Michel-0/Nixie/NTC/CAD/GPS.FCStd

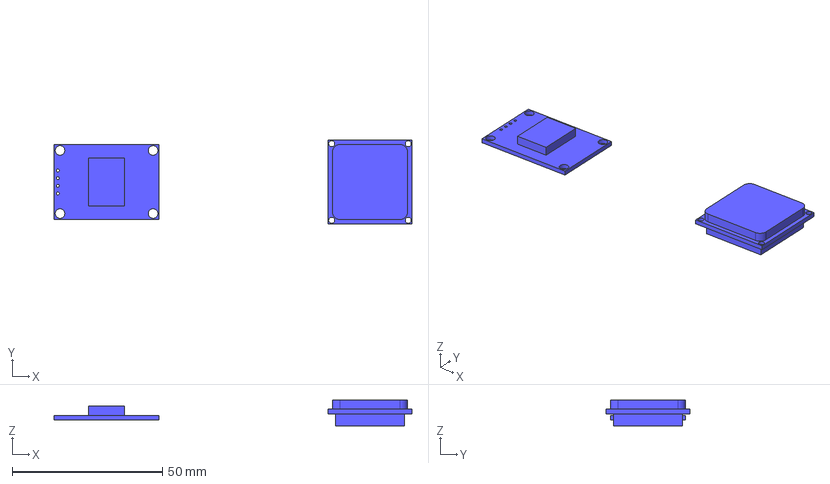
[picture p1: CAD file, 2025-02-01]
NTC/CAD/GPS.FCStd
119.3 x 28.0 x 8.50 mm
