Michel-0/Nixie/NTC/CAD/RTC.FCStd

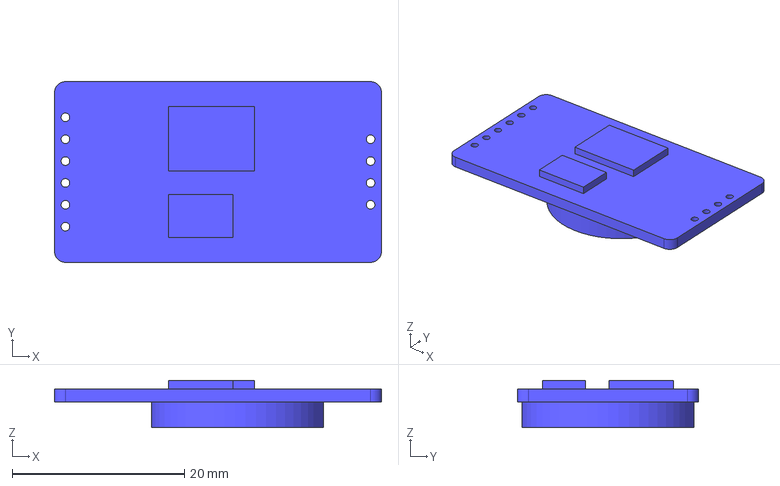
[picture p2: CAD file, 2025-01-15]
NTC/CAD/RTC.FCStd
38.0 x 21.0 x 5.50 mm
