Michel-0/Nixie/NTC/CAD/IN-3.FCStd

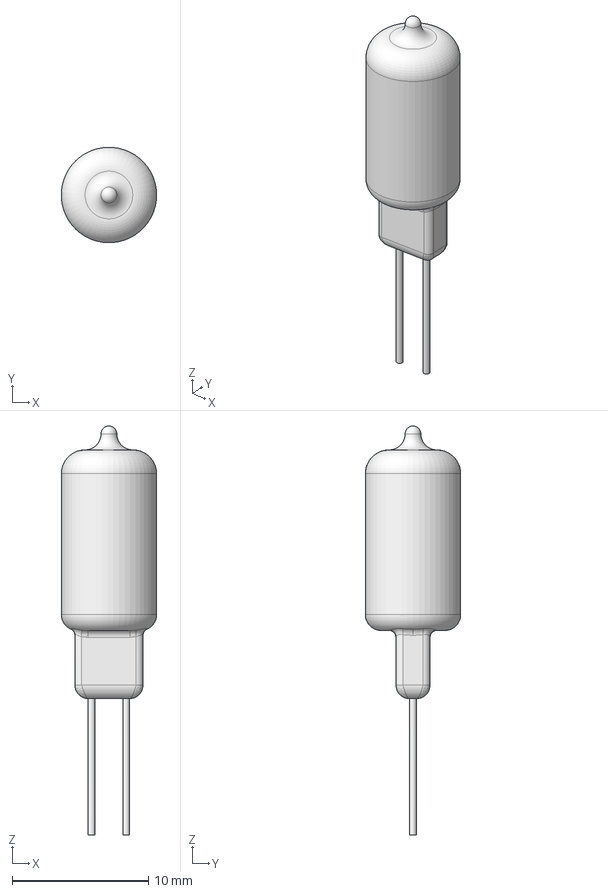
[picture p3: CAD file, 2025-01-02]
NTC/CAD/IN-3.FCStd
6.99 x 7.00 x 30.0 mm
