Michel-0/Nixie/NTC/CAD/PCB_5x6.FCStd

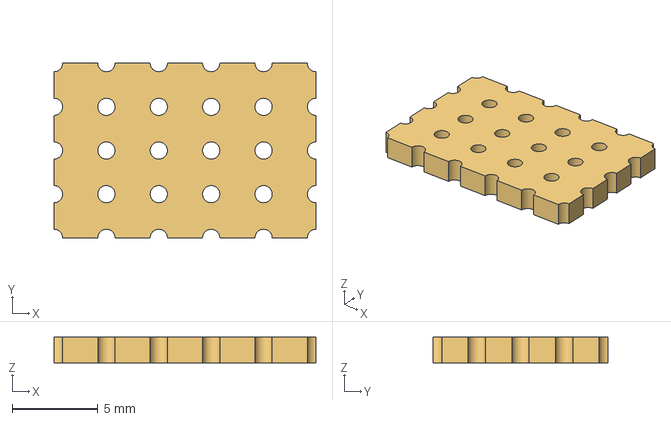
[picture p4: CAD file, 2025-01-02]
NTC/CAD/PCB_5x6.FCStd
15.2 x 10.2 x 1.50 mm
