Michel-0/Nixie/NTC/CAD/DCDC.FCStd

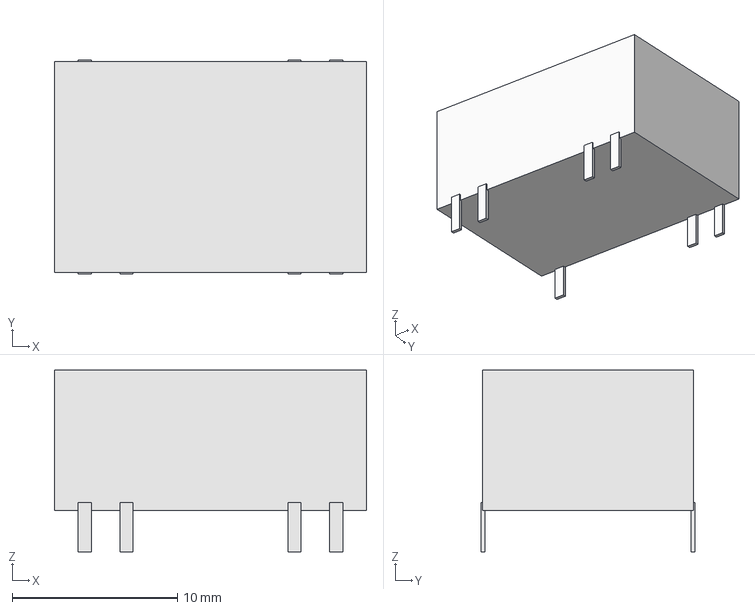
[picture p5: CAD file, 2025-01-01]
NTC/CAD/DCDC.FCStd
18.9 x 12.9 x 11.0 mm
