Michel-0/Nixie/NTC/CAD/IN-14.FCStd

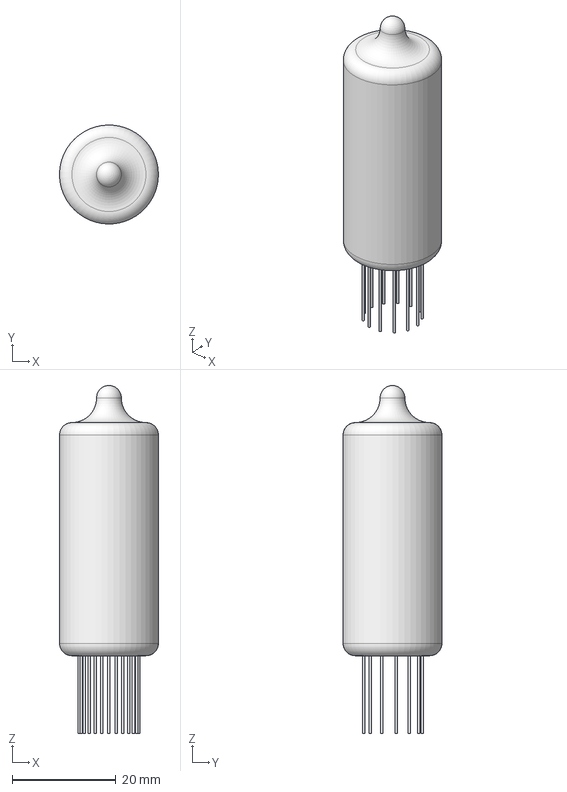
[picture p7: CAD file, 2025-01-01]
NTC/CAD/IN-14.FCStd
19.1 x 19.1 x 67.2 mm
