Michel-0/Nixie/NTC/CAD/DCF77.FCStd

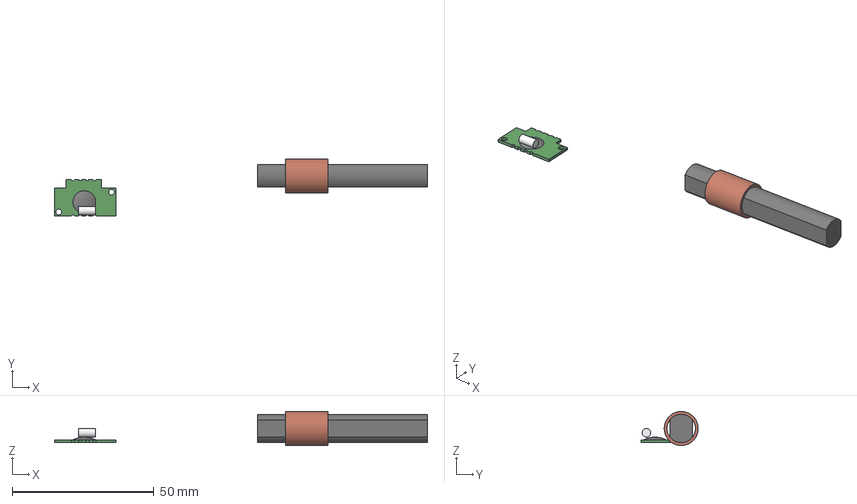
[picture p8: CAD file, 2025-01-01]
NTC/CAD/DCF77.FCStd
131.5 x 20.3 x 12.0 mm
Zylinder
