Michel-0/Nixie/NTC/Main.kicad_pcb

## KiCad design NTC/Main.kicad_pcb (2025-02-01)

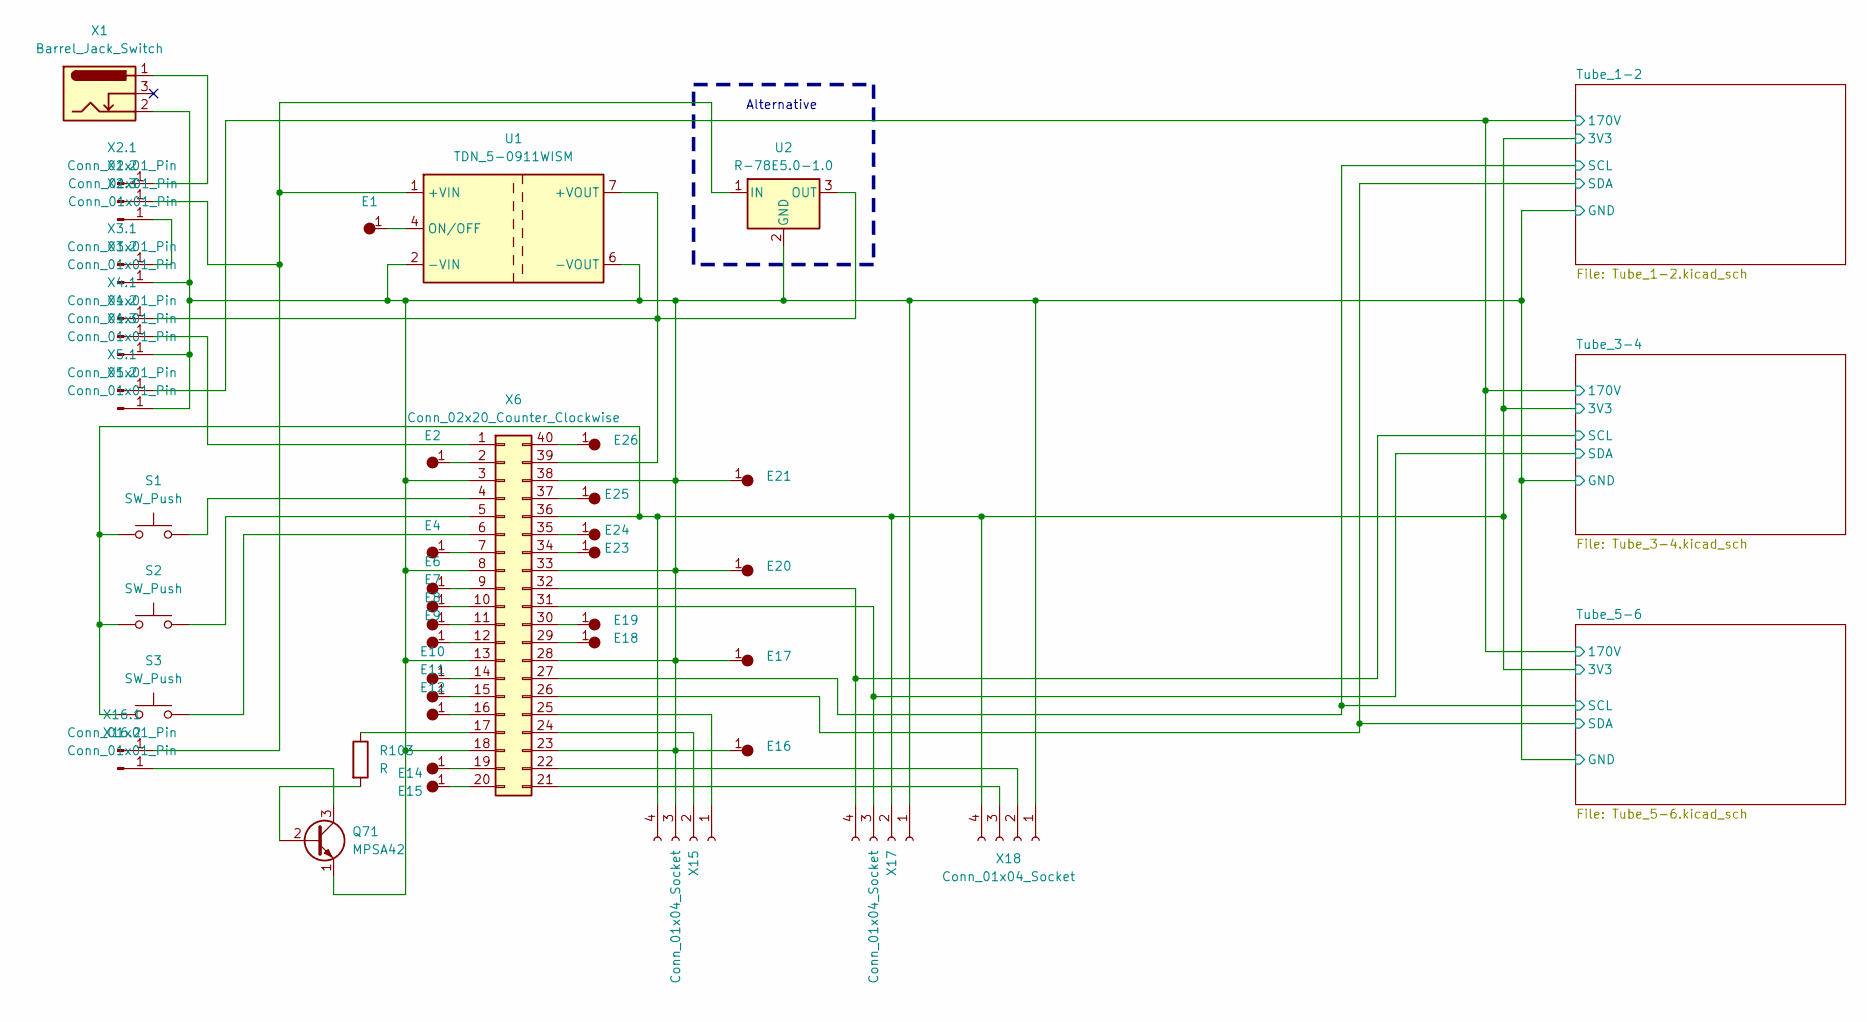
[picture p9: schematic Main.kicad_sch]

Parts:
E1, E2, E4, E6, E7, E8, E9, E10, E11, E12, E14, E15, E16, E17, E18, E19, E20, E21, E23, E24, E25, E26: SingleHole
Q71: MPSA42; MPSA-42
R103: R; Resistor-a
S1, S2, S3: SW_Push; Button
U1: TDN_5-0911WISM; DCDC_12V-5V-3W
U2: R-78E5.0-1.0; DCDC_12V-5V-5W
X1: Barrel_Jack_Switch; Socket_5-5
X2.1, X2.2, X2.3, X3.1, X3.2, X4.1, X4.2, X4.3, X5.1, X5.2, X16.1, X16.2: Conn_01x01_Pin; Pin_D1.0mm_L10.0mm
X6: Conn_02x20_Counter_Clockwise; Pinbar_1-20-f
X15: Conn_01x04_Socket; Pinbar_1-4-f-b
X17: Conn_01x04_Socket; Pinbar_1-4-f-c
X18: Conn_01x04_Socket; Pinbar_1-4-f-d

Connections:
/Tube_1-2/3V3: S1.1, S2.1, S3.1, X6.36, X15.4, X17.2, X18.4; also elsewhere on the board
/Tube_1-2/170V: X5.1.1; also elsewhere on the board
/Tube_1-2/GND: E16.1, E17.1, E20.1, E21.1, Q71.1 (E), U1.2 (-VIN), U1.6 (-VOUT), U2.2 (GND), X1.2, X3.2.1, X4.3.1, X5.2.1, X6.3, X6.8, X6.13, X6.18, X6.23, X6.28, X6.33, X6.38, X15.3, X17.1, X18.1; also elsewhere on the board
/Tube_1-2/SCL: X6.27; also elsewhere on the board
/Tube_1-2/SDA: X6.26; also elsewhere on the board
/Tube_3-4/SCL: X6.32, X17.4; also elsewhere on the board
/Tube_3-4/SDA: X6.31, X17.3; also elsewhere on the board
unnamed: Q71.2 (B), R103.2
unnamed: Q71.3 (C), X16.2.1
unnamed: U1.1 (+VIN), U2.1 (IN), X2.2.1, X16.1.1
unnamed: U1.7 (+VOUT), U2.3 (OUT), X4.1.1, X6.39
unnamed: E1.1, U1.4 (ON/OFF)
unnamed: X1.1, X2.1.1
unnamed: X2.3.1, X3.1.1
unnamed: X4.2.1, X6.1
unnamed: E2.1, X6.2
unnamed: S1.2, X6.4
unnamed: S2.2, X6.5
unnamed: S3.2, X6.6
unnamed: E4.1, X6.7
unnamed: E6.1, X6.9
unnamed: E7.1, X6.10
unnamed: E8.1, X6.11
unnamed: E9.1, X6.12
unnamed: E10.1, X6.14
unnamed: E11.1, X6.15
unnamed: E12.1, X6.16
unnamed: R103.1, X6.17
unnamed: E14.1, X6.19
unnamed: E15.1, X6.20
unnamed: E18.1, X6.29
unnamed: E19.1, X6.30
unnamed: E23.1, X6.34
unnamed: E24.1, X6.35
unnamed: E25.1, X6.37
unnamed: E26.1, X6.40
unnamed: X6.25, X15.1
unnamed: X6.24, X15.2
unnamed: X6.22, X18.2
unnamed: X6.21, X18.3

Notes on the sheet:
Alternative

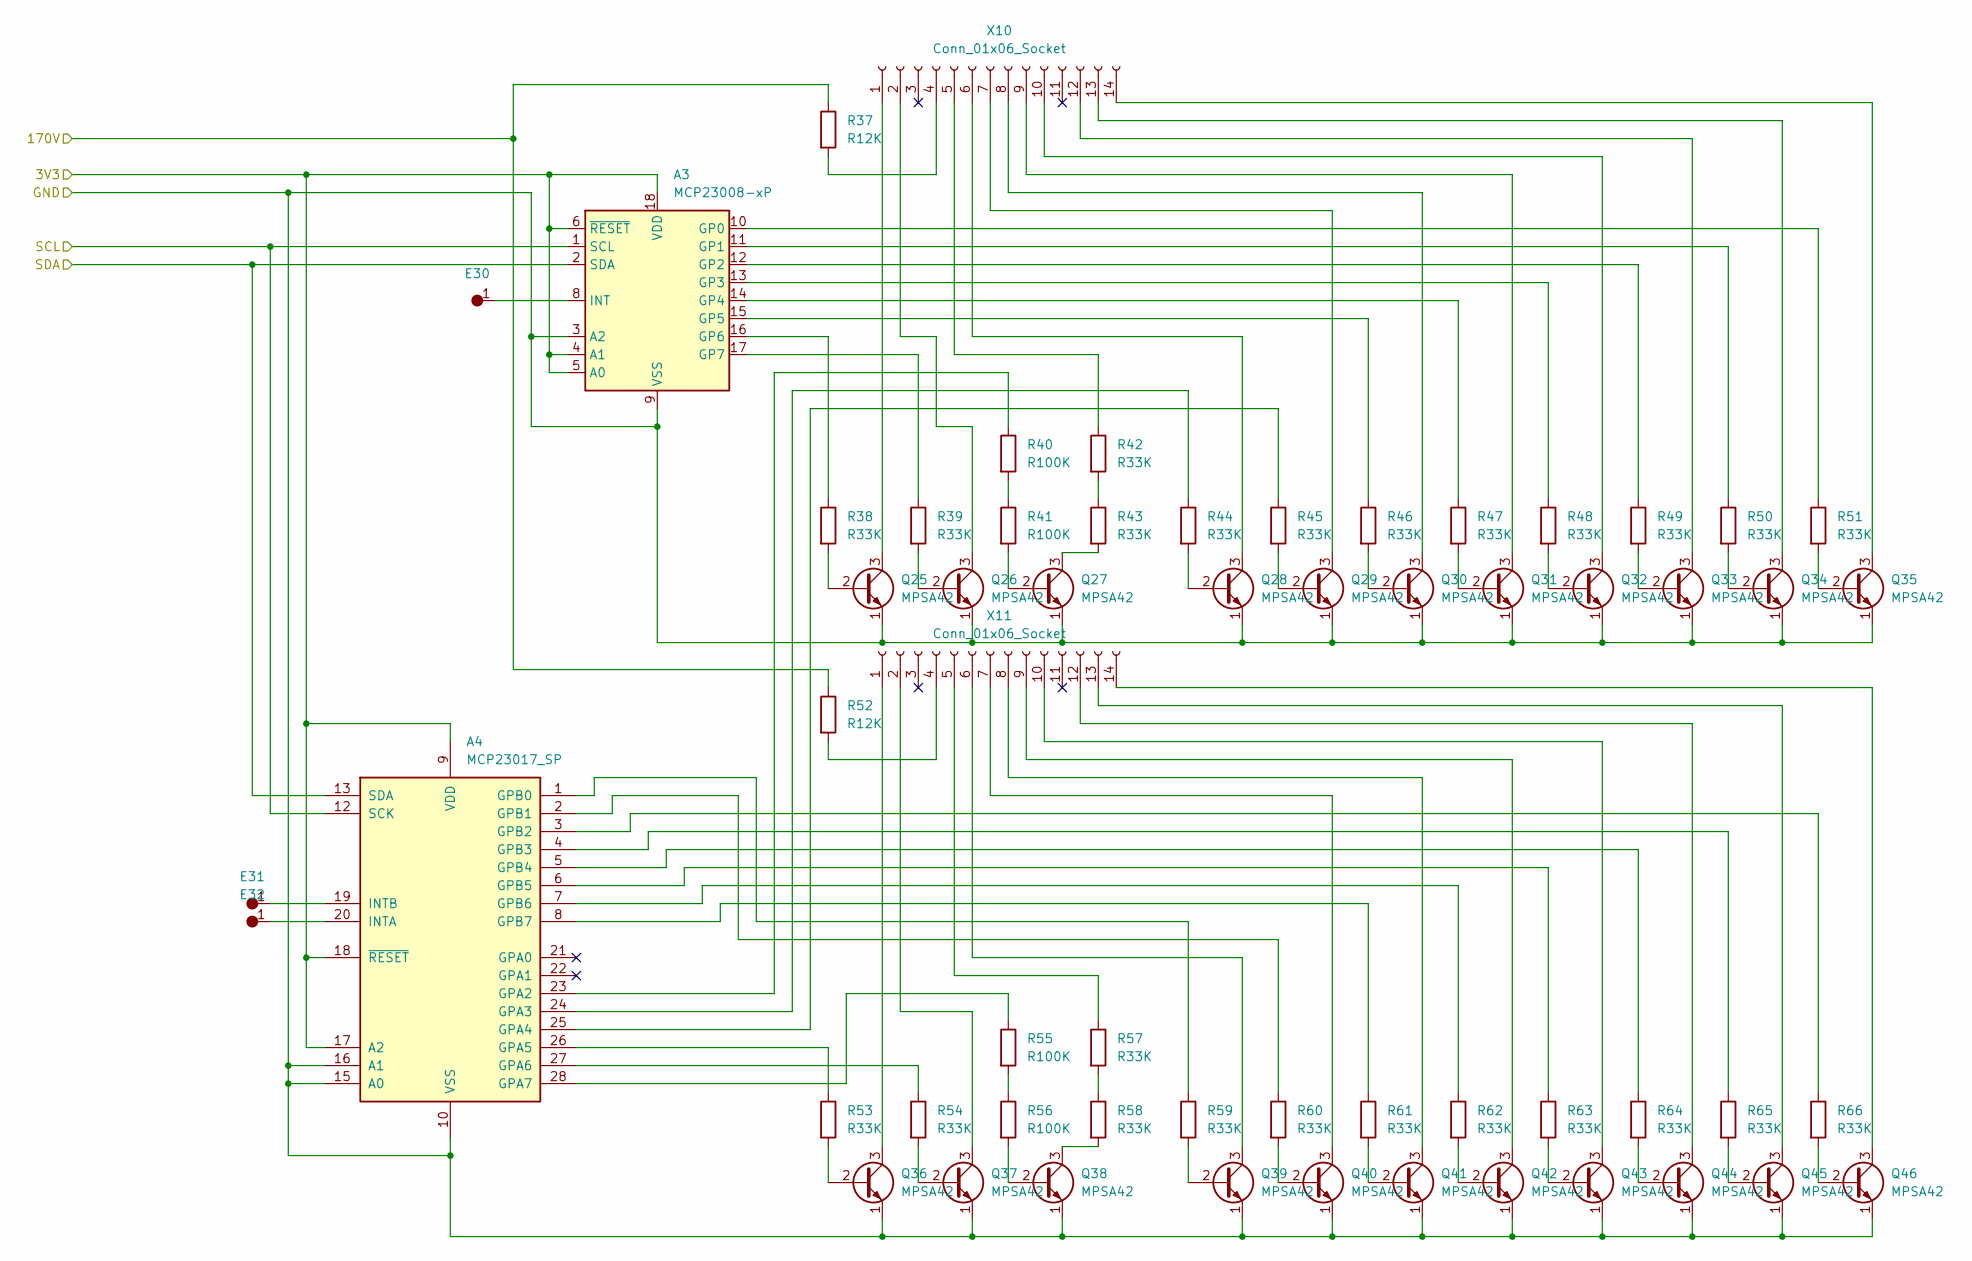
[picture p10: schematic Tube_3-4.kicad_sch]

Parts:
A3: MCP23008-xP; DIP-18_IC+Socket
A4: MCP23017_SP; DIP-28_IC+Socket
E30, E31, E32: SingleHole
Q25, Q26, Q27, Q28, Q29, Q30, Q31, Q32, Q33, Q34, Q35, Q36, Q37, Q38, Q39, Q40, Q41, Q42, Q43, Q44, Q45, Q46: MPSA42; MPSA-42
R37, R52: R12K; Resistor-a
R38, R39, R42, R43, R44, R45, R46, R47, R48, R49, R50, R51, R53, R54, R57, R58, R59, R60, R61, R62, R63, R64, R65, R66: R33K; Resistor-a
R40, R41, R55, R56: R100K; Resistor-a
X10, X11: Conn_01x06_Socket; Pinbar_4-14-f

Connections:
/Tube_1-2/3V3: A3.4 (A1), A3.5 (A0), A3.6 (~RESET), A3.18 (VDD), A4.9 (VDD), A4.17 (A2), A4.18 (~RESET); also elsewhere on the board
/Tube_1-2/170V: R37.1, R52.1; also elsewhere on the board
/Tube_1-2/GND: A3.3 (A2), A3.9 (VSS), A4.10 (VSS), A4.15 (A0), A4.16 (A1), Q25.1 (E), Q26.1 (E), Q27.1 (E), Q28.1 (E), Q29.1 (E), Q30.1 (E), Q31.1 (E), Q32.1 (E), Q33.1 (E), Q34.1 (E), Q35.1 (E), Q36.1 (E), Q37.1 (E), Q38.1 (E), Q39.1 (E), Q40.1 (E), Q41.1 (E), Q42.1 (E), Q43.1 (E), Q44.1 (E), Q45.1 (E), Q46.1 (E); also elsewhere on the board
/Tube_3-4/SCL: A3.1 (SCL), A4.12 (SCK); also elsewhere on the board
/Tube_3-4/SDA: A3.2 (SDA), A4.13 (SDA); also elsewhere on the board
unnamed: A3.10 (GP0), R51.1
unnamed: A3.11 (GP1), R50.1
unnamed: A3.12 (GP2), R49.1
unnamed: A3.13 (GP3), R48.1
unnamed: A3.14 (GP4), R47.1
unnamed: A3.15 (GP5), R46.1
unnamed: A3.16 (GP6), R38.1
unnamed: A3.17 (GP7), R39.1
unnamed: A3.8 (INT), E30.1
unnamed: A4.23 (GPA2), R40.1
unnamed: A4.24 (GPA3), R44.1
unnamed: A4.25 (GPA4), R45.1
unnamed: A4.26 (GPA5), R53.1
unnamed: A4.27 (GPA6), R54.1
unnamed: A4.28 (GPA7), R55.1
unnamed: A4.1 (GPB0), R59.1
unnamed: A4.2 (GPB1), R60.1
unnamed: A4.3 (GPB2), R66.1
unnamed: A4.4 (GPB3), R65.1
unnamed: A4.5 (GPB4), R64.1
unnamed: A4.6 (GPB5), R63.1
unnamed: A4.7 (GPB6), R62.1
unnamed: A4.8 (GPB7), R61.1
unnamed: A4.20 (INTA), E32.1
unnamed: A4.19 (INTB), E31.1
unnamed: Q25.2 (B), R38.2
unnamed: Q25.3 (C), X10.1
unnamed: Q26.2 (B), R39.2
unnamed: Q26.3 (C), X10.2
unnamed: Q27.2 (B), R41.2
unnamed: Q27.3 (C), R43.2
unnamed: Q28.2 (B), R44.2
unnamed: Q28.3 (C), X10.6
unnamed: Q29.2 (B), R45.2
unnamed: Q29.3 (C), X10.7
unnamed: Q30.2 (B), R46.2
unnamed: Q30.3 (C), X10.8
unnamed: Q31.2 (B), R47.2
unnamed: Q31.3 (C), X10.9
unnamed: Q32.2 (B), R48.2
unnamed: Q32.3 (C), X10.10
unnamed: Q33.2 (B), R49.2
unnamed: Q33.3 (C), X10.12
unnamed: Q34.2 (B), R50.2
unnamed: Q34.3 (C), X10.13
unnamed: Q35.2 (B), R51.2
unnamed: Q35.3 (C), X10.14
unnamed: Q36.2 (B), R53.2
unnamed: Q36.3 (C), X11.1
unnamed: Q37.2 (B), R54.2
unnamed: Q37.3 (C), X11.2
unnamed: Q38.2 (B), R56.2
unnamed: Q38.3 (C), R58.2
unnamed: Q39.2 (B), R59.2
unnamed: Q39.3 (C), X11.6
unnamed: Q40.2 (B), R60.2
unnamed: Q40.3 (C), X11.7
unnamed: Q41.2 (B), R61.2
unnamed: Q41.3 (C), X11.8
unnamed: Q42.2 (B), R62.2
unnamed: Q42.3 (C), X11.9
unnamed: Q43.2 (B), R63.2
unnamed: Q43.3 (C), X11.10
unnamed: Q44.2 (B), R64.2
unnamed: Q44.3 (C), X11.12
unnamed: Q45.2 (B), R65.2
unnamed: Q45.3 (C), X11.13
unnamed: Q46.2 (B), R66.2
unnamed: Q46.3 (C), X11.14
unnamed: R40.2, R41.1
unnamed: R42.2, R43.1
unnamed: R55.2, R56.1
unnamed: R57.2, R58.1
unnamed: R37.2, X10.4
unnamed: R42.1, X10.5
unnamed: R52.2, X11.4
unnamed: R57.1, X11.5

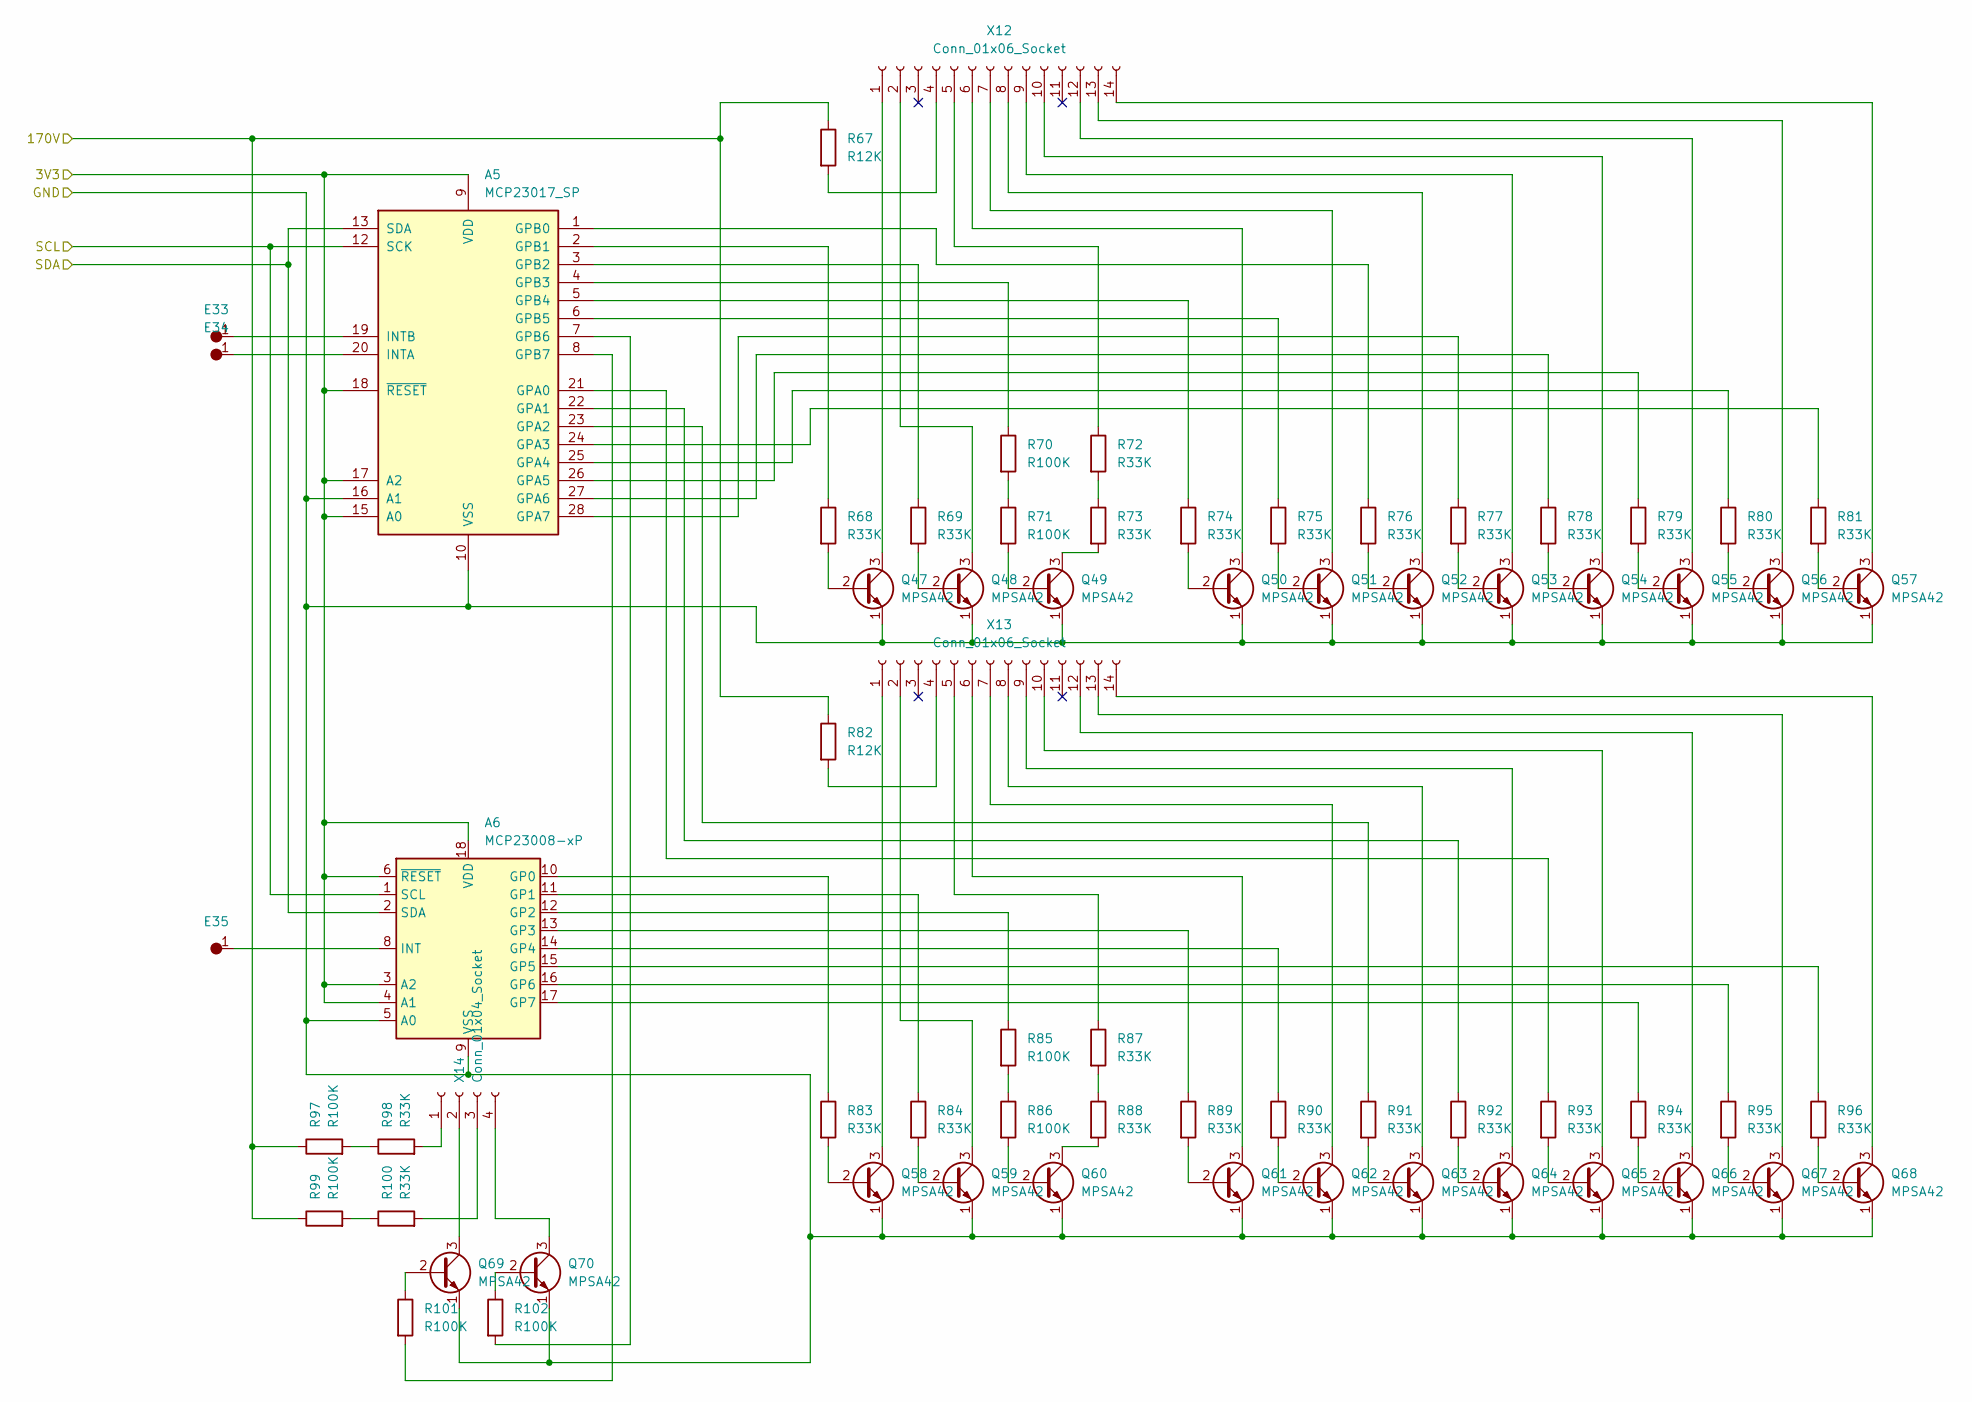
[picture p11: schematic Tube_5-6.kicad_sch]

Parts:
A5: MCP23017_SP; DIP-28_IC+Socket
A6: MCP23008-xP; DIP-18_IC+Socket
E33, E34, E35: SingleHole
Q47, Q48, Q49, Q50, Q51, Q52, Q53, Q54, Q55, Q56, Q57, Q58, Q59, Q60, Q61, Q62, Q63, Q64, Q65, Q66, Q67, Q68, Q69, Q70: MPSA42; MPSA-42
R67, R82: R12K; Resistor-a
R68, R69, R72, R73, R74, R75, R76, R77, R78, R79, R80, R81, R83, R84, R87, R88, R89, R90, R91, R92, R93, R94, R95, R96, R98, R100: R33K; Resistor-a
R70, R71, R85, R86, R97, R99, R101, R102: R100K; Resistor-a
X12, X13: Conn_01x06_Socket; Pinbar_4-14-f
X14: Conn_01x04_Socket; Pinbar_1-4-f-a

Connections:
/Tube_1-2/3V3: A5.9 (VDD), A5.15 (A0), A5.17 (A2), A5.18 (~RESET), A6.3 (A2), A6.4 (A1), A6.6 (~RESET), A6.18 (VDD); also elsewhere on the board
/Tube_1-2/170V: R67.1, R82.1, R97.1, R99.1; also elsewhere on the board
/Tube_1-2/GND: A5.10 (VSS), A5.16 (A1), A6.5 (A0), A6.9 (VSS), Q47.1 (E), Q48.1 (E), Q49.1 (E), Q50.1 (E), Q51.1 (E), Q52.1 (E), Q53.1 (E), Q54.1 (E), Q55.1 (E), Q56.1 (E), Q57.1 (E), Q58.1 (E), Q59.1 (E), Q60.1 (E), Q61.1 (E), Q62.1 (E), Q63.1 (E), Q64.1 (E), Q65.1 (E), Q66.1 (E), Q67.1 (E), Q68.1 (E), Q69.1 (E), Q70.1 (E); also elsewhere on the board
/Tube_1-2/SCL: A5.12 (SCK), A6.1 (SCL); also elsewhere on the board
/Tube_1-2/SDA: A5.13 (SDA), A6.2 (SDA); also elsewhere on the board
unnamed: A5.21 (GPA0), R93.1
unnamed: A5.22 (GPA1), R92.1
unnamed: A5.23 (GPA2), R91.1
unnamed: A5.24 (GPA3), R81.1
unnamed: A5.25 (GPA4), R80.1
unnamed: A5.26 (GPA5), R79.1
unnamed: A5.27 (GPA6), R78.1
unnamed: A5.28 (GPA7), R77.1
unnamed: A5.1 (GPB0), R76.1
unnamed: A5.2 (GPB1), R68.1
unnamed: A5.3 (GPB2), R69.1
unnamed: A5.4 (GPB3), R70.1
unnamed: A5.5 (GPB4), R74.1
unnamed: A5.6 (GPB5), R75.1
unnamed: A5.7 (GPB6), R102.2
unnamed: A5.8 (GPB7), R101.2
unnamed: A5.20 (INTA), E34.1
unnamed: A5.19 (INTB), E33.1
unnamed: A6.10 (GP0), R83.1
unnamed: A6.11 (GP1), R84.1
unnamed: A6.12 (GP2), R85.1
unnamed: A6.13 (GP3), R89.1
unnamed: A6.14 (GP4), R90.1
unnamed: A6.15 (GP5), R96.1
unnamed: A6.16 (GP6), R95.1
unnamed: A6.17 (GP7), R94.1
unnamed: A6.8 (INT), E35.1
unnamed: Q47.2 (B), R68.2
unnamed: Q47.3 (C), X12.1
unnamed: Q48.2 (B), R69.2
unnamed: Q48.3 (C), X12.2
unnamed: Q49.2 (B), R71.2
unnamed: Q49.3 (C), R73.2
unnamed: Q50.2 (B), R74.2
unnamed: Q50.3 (C), X12.6
unnamed: Q51.2 (B), R75.2
unnamed: Q51.3 (C), X12.7
unnamed: Q52.2 (B), R76.2
unnamed: Q52.3 (C), X12.8
unnamed: Q53.2 (B), R77.2
unnamed: Q53.3 (C), X12.9
unnamed: Q54.2 (B), R78.2
unnamed: Q54.3 (C), X12.10
unnamed: Q55.2 (B), R79.2
unnamed: Q55.3 (C), X12.12
unnamed: Q56.2 (B), R80.2
unnamed: Q56.3 (C), X12.13
unnamed: Q57.2 (B), R81.2
unnamed: Q57.3 (C), X12.14
unnamed: Q58.2 (B), R83.2
unnamed: Q58.3 (C), X13.1
unnamed: Q59.2 (B), R84.2
unnamed: Q59.3 (C), X13.2
unnamed: Q60.2 (B), R86.2
unnamed: Q60.3 (C), R88.2
unnamed: Q61.2 (B), R89.2
unnamed: Q61.3 (C), X13.6
unnamed: Q62.2 (B), R90.2
unnamed: Q62.3 (C), X13.7
unnamed: Q63.2 (B), R91.2
unnamed: Q63.3 (C), X13.8
unnamed: Q64.2 (B), R92.2
unnamed: Q64.3 (C), X13.9
unnamed: Q65.2 (B), R93.2
unnamed: Q65.3 (C), X13.10
unnamed: Q66.2 (B), R94.2
unnamed: Q66.3 (C), X13.12
unnamed: Q67.2 (B), R95.2
unnamed: Q67.3 (C), X13.13
unnamed: Q68.2 (B), R96.2
unnamed: Q68.3 (C), X13.14
unnamed: Q69.2 (B), R101.1
unnamed: Q69.3 (C), X14.2
unnamed: Q70.2 (B), R102.1
unnamed: Q70.3 (C), X14.4
unnamed: R70.2, R71.1
unnamed: R72.2, R73.1
unnamed: R85.2, R86.1
unnamed: R87.2, R88.1
unnamed: R97.2, R98.1
unnamed: R99.2, R100.1
unnamed: R67.2, X12.4
unnamed: R72.1, X12.5
unnamed: R82.2, X13.4
unnamed: R87.1, X13.5
unnamed: R98.2, X14.1
unnamed: R100.2, X14.3

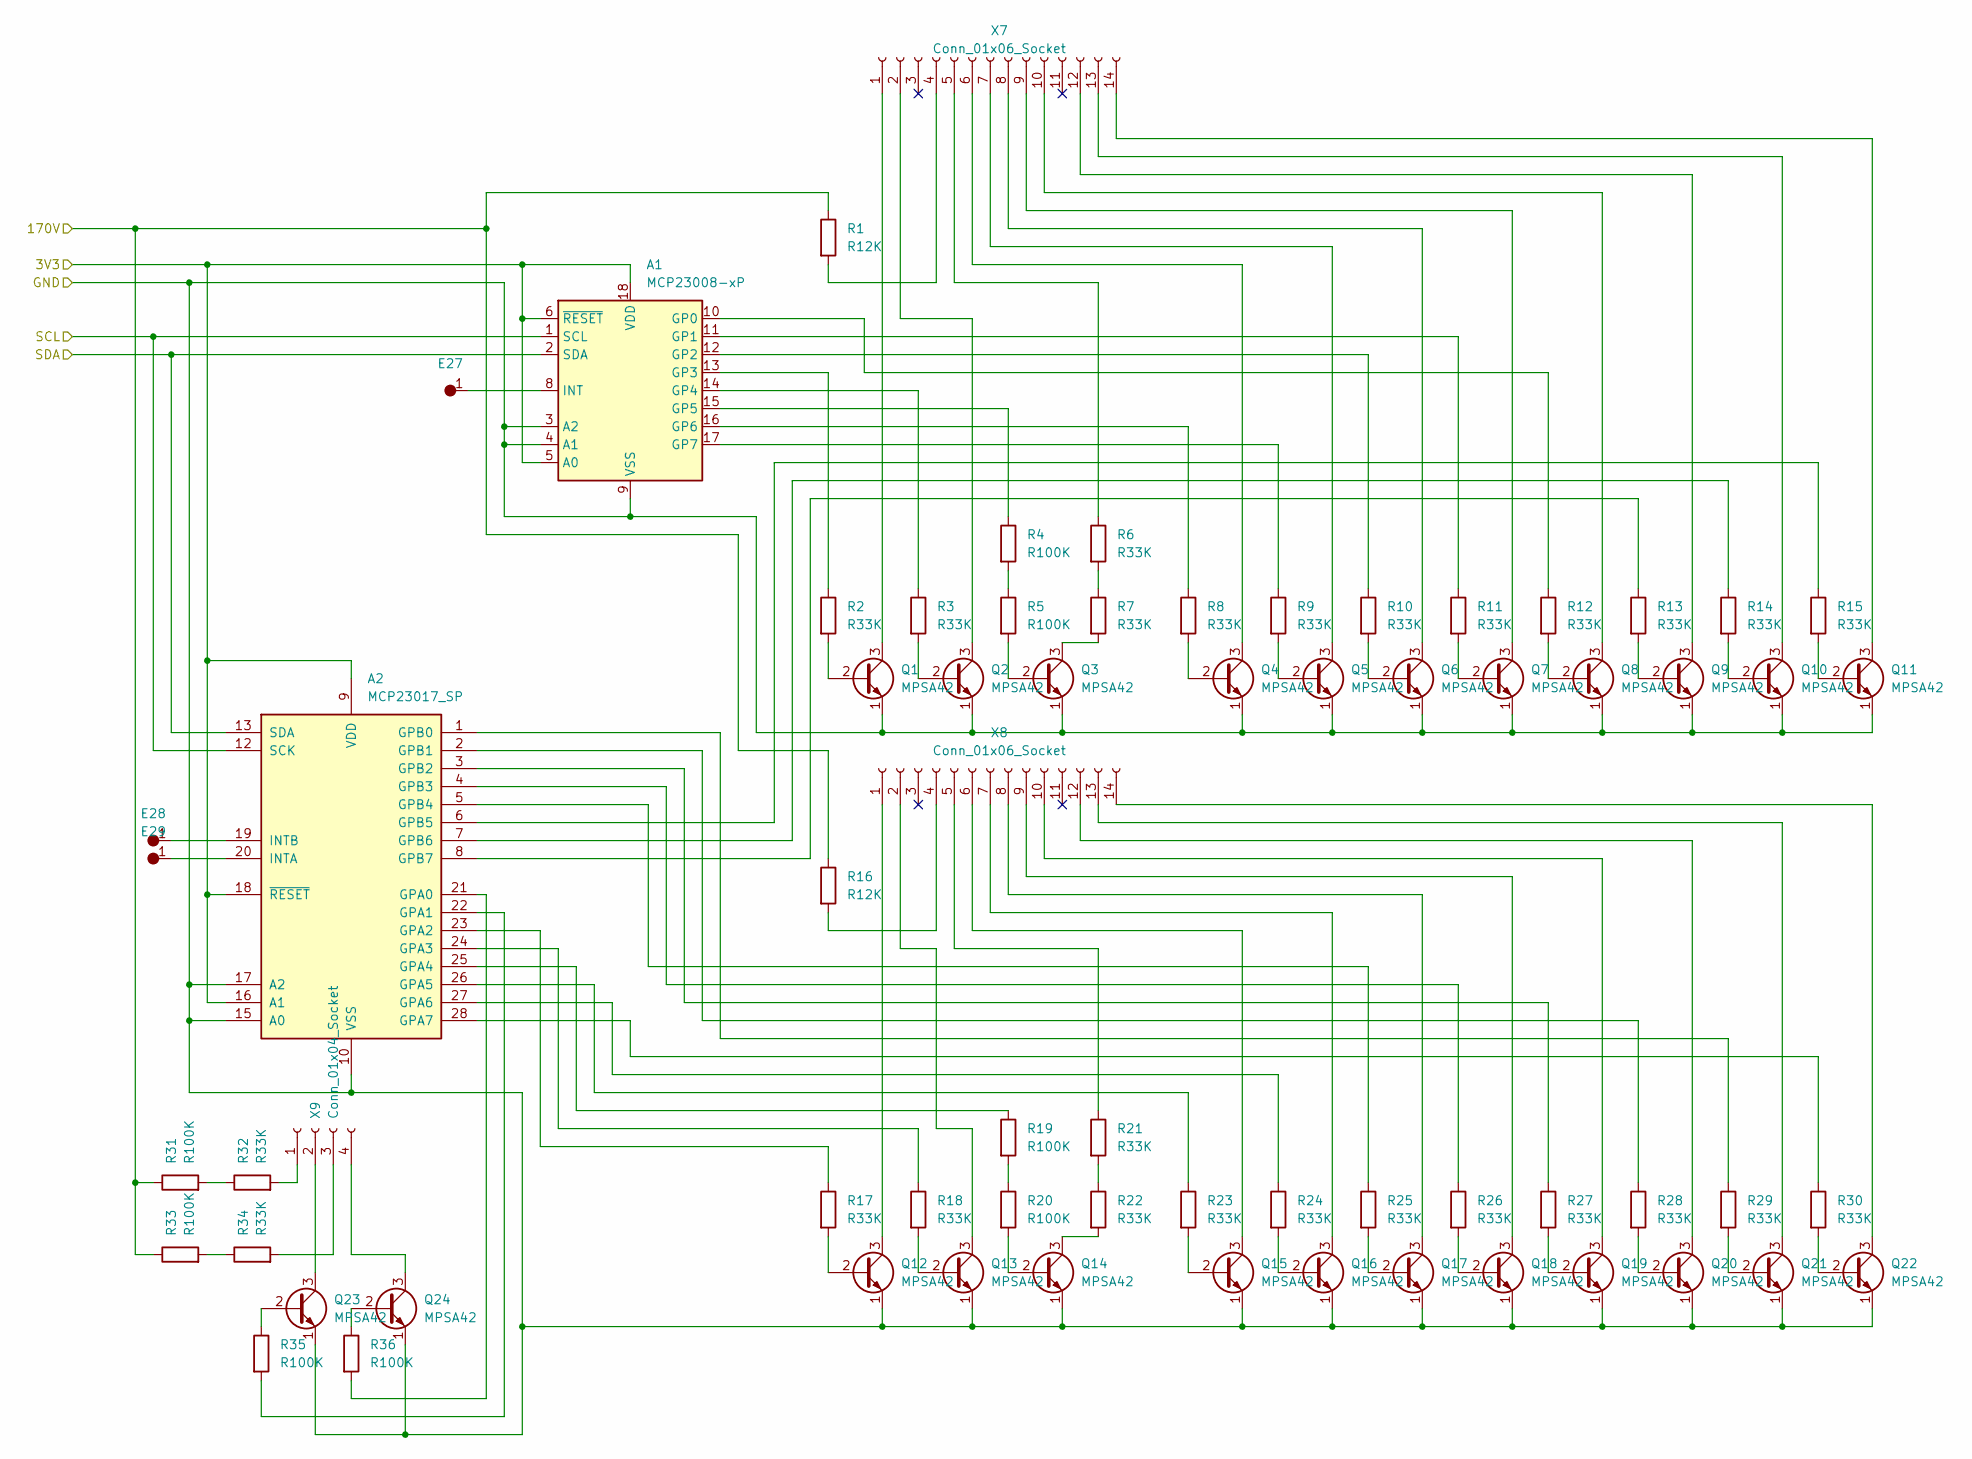
[picture p12: schematic Tube_1-2.kicad_sch]

Parts:
A1: MCP23008-xP; DIP-18_IC+Socket
A2: MCP23017_SP; DIP-28_IC+Socket
E27, E28, E29: SingleHole
Q1, Q2, Q3, Q4, Q5, Q6, Q7, Q8, Q9, Q10, Q11, Q12, Q13, Q14, Q15, Q16, Q17, Q18, Q19, Q20, Q21, Q22, Q23, Q24: MPSA42; MPSA-42
R1, R16: R12K; Resistor-a
R2, R3, R6, R7, R8, R9, R10, R11, R12, R13, R14, R15, R17, R18, R21, R22, R23, R24, R25, R26, R27, R28, R29, R30, R32, R34: R33K; Resistor-a
R4, R5, R19, R20, R31, R33, R35, R36: R100K; Resistor-a
X7, X8: Conn_01x06_Socket; Pinbar_4-14-f
X9: Conn_01x04_Socket; Pinbar_1-4-f-a

Connections:
/Tube_1-2/3V3: A1.5 (A0), A1.6 (~RESET), A1.18 (VDD), A2.9 (VDD), A2.16 (A1), A2.18 (~RESET); also elsewhere on the board
/Tube_1-2/170V: R1.1, R16.1, R31.1, R33.1; also elsewhere on the board
/Tube_1-2/GND: A1.3 (A2), A1.4 (A1), A1.9 (VSS), A2.10 (VSS), A2.15 (A0), A2.17 (A2), Q1.1 (E), Q2.1 (E), Q3.1 (E), Q4.1 (E), Q5.1 (E), Q6.1 (E), Q7.1 (E), Q8.1 (E), Q9.1 (E), Q10.1 (E), Q11.1 (E), Q12.1 (E), Q13.1 (E), Q14.1 (E), Q15.1 (E), Q16.1 (E), Q17.1 (E), Q18.1 (E), Q19.1 (E), Q20.1 (E), Q21.1 (E), Q22.1 (E), Q23.1 (E), Q24.1 (E); also elsewhere on the board
/Tube_1-2/SCL: A1.1 (SCL), A2.12 (SCK); also elsewhere on the board
/Tube_1-2/SDA: A1.2 (SDA), A2.13 (SDA); also elsewhere on the board
unnamed: A1.10 (GP0), R12.1
unnamed: A1.11 (GP1), R11.1
unnamed: A1.12 (GP2), R10.1
unnamed: A1.13 (GP3), R2.1
unnamed: A1.14 (GP4), R3.1
unnamed: A1.15 (GP5), R4.1
unnamed: A1.16 (GP6), R8.1
unnamed: A1.17 (GP7), R9.1
unnamed: A1.8 (INT), E27.1
unnamed: A2.21 (GPA0), R36.2
unnamed: A2.22 (GPA1), R35.2
unnamed: A2.23 (GPA2), R17.1
unnamed: A2.24 (GPA3), R18.1
unnamed: A2.25 (GPA4), R19.1
unnamed: A2.26 (GPA5), R23.1
unnamed: A2.27 (GPA6), R24.1
unnamed: A2.28 (GPA7), R30.1
unnamed: A2.1 (GPB0), R29.1
unnamed: A2.2 (GPB1), R28.1
unnamed: A2.3 (GPB2), R27.1
unnamed: A2.4 (GPB3), R26.1
unnamed: A2.5 (GPB4), R25.1
unnamed: A2.6 (GPB5), R15.1
unnamed: A2.7 (GPB6), R14.1
unnamed: A2.8 (GPB7), R13.1
unnamed: A2.20 (INTA), E29.1
unnamed: A2.19 (INTB), E28.1
unnamed: Q1.2 (B), R2.2
unnamed: Q1.3 (C), X7.1
unnamed: Q2.2 (B), R3.2
unnamed: Q2.3 (C), X7.2
unnamed: Q3.2 (B), R5.2
unnamed: Q3.3 (C), R7.2
unnamed: Q4.2 (B), R8.2
unnamed: Q4.3 (C), X7.6
unnamed: Q5.2 (B), R9.2
unnamed: Q5.3 (C), X7.7
unnamed: Q6.2 (B), R10.2
unnamed: Q6.3 (C), X7.8
unnamed: Q7.2 (B), R11.2
unnamed: Q7.3 (C), X7.9
unnamed: Q8.2 (B), R12.2
unnamed: Q8.3 (C), X7.10
unnamed: Q9.2 (B), R13.2
unnamed: Q9.3 (C), X7.12
unnamed: Q10.2 (B), R14.2
unnamed: Q10.3 (C), X7.13
unnamed: Q11.2 (B), R15.2
unnamed: Q11.3 (C), X7.14
unnamed: Q12.2 (B), R17.2
unnamed: Q12.3 (C), X8.1
unnamed: Q13.2 (B), R18.2
unnamed: Q13.3 (C), X8.2
unnamed: Q14.2 (B), R20.2
unnamed: Q14.3 (C), R22.2
unnamed: Q15.2 (B), R23.2
unnamed: Q15.3 (C), X8.6
unnamed: Q16.2 (B), R24.2
unnamed: Q16.3 (C), X8.7
unnamed: Q17.2 (B), R25.2
unnamed: Q17.3 (C), X8.8
unnamed: Q18.2 (B), R26.2
unnamed: Q18.3 (C), X8.9
unnamed: Q19.2 (B), R27.2
unnamed: Q19.3 (C), X8.10
unnamed: Q20.2 (B), R28.2
unnamed: Q20.3 (C), X8.12
unnamed: Q21.2 (B), R29.2
unnamed: Q21.3 (C), X8.13
unnamed: Q22.2 (B), R30.2
unnamed: Q22.3 (C), X8.14
unnamed: Q23.2 (B), R35.1
unnamed: Q23.3 (C), X9.2
unnamed: Q24.2 (B), R36.1
unnamed: Q24.3 (C), X9.4
unnamed: R4.2, R5.1
unnamed: R6.2, R7.1
unnamed: R19.2, R20.1
unnamed: R21.2, R22.1
unnamed: R31.2, R32.1
unnamed: R33.2, R34.1
unnamed: R1.2, X7.4
unnamed: R6.1, X7.5
unnamed: R16.2, X8.4
unnamed: R21.1, X8.5
unnamed: R32.2, X9.1
unnamed: R34.2, X9.3

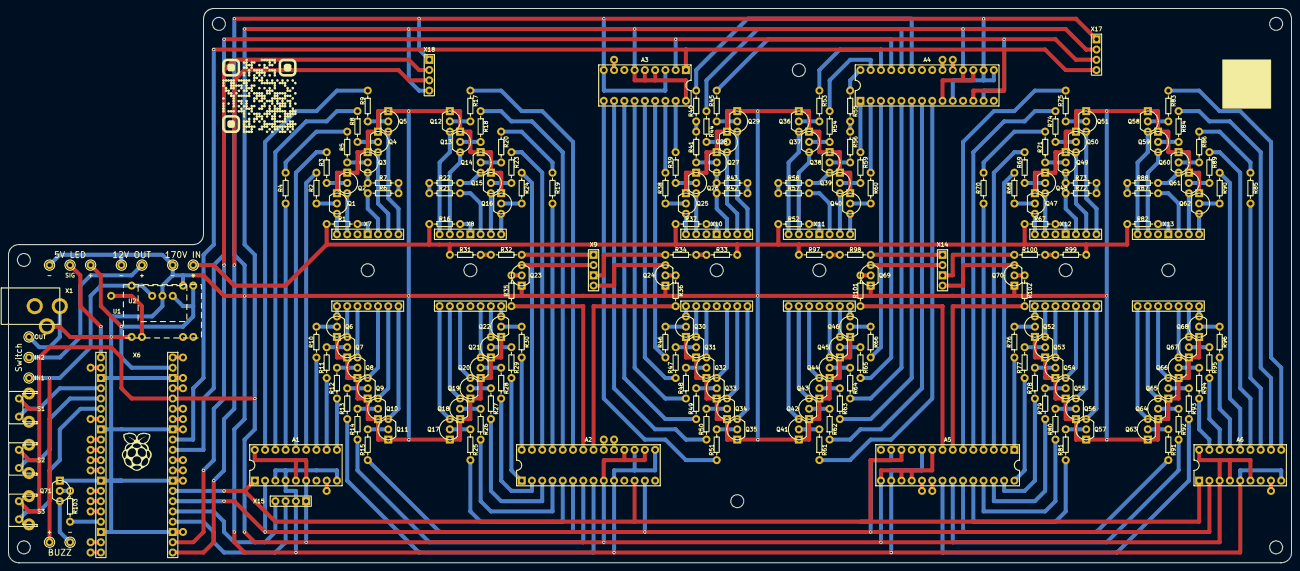
[picture p13: board Main.kicad_pcb from above]

Board: 2 copper layers, 317.5 x 137.2 mm, 241 parts (0 on the bottom side), 291 nets.
