Michel-0/Nixie/(commit log)

2025-01-01 Added KiCAD project
    [DCDC.FCStd, DCF77.FCStd, IN-14.FCStd, Main.kicad_pcb, Main.kicad_sch, Pico-R3.step, Socket.kicad_pcb, Tube_1-2.kicad_sch]
2025-01-01 Added QR
    [Main.kicad_pcb]
2025-01-02 added soldermask expansion
    [IN-3.FCStd, Main.kicad_pcb, PCB_5x6.FCStd]
2025-01-03 Added alternative DC/DC converter and Tube schematic
    [Main.kicad_pcb, Main.kicad_sch, Socket.kicad_pcb, Socket.kicad_sch]
2025-01-06 Changed to 14pin socket
    [Main.kicad_pcb, Main.kicad_sch, Socket.kicad_pcb, Socket.kicad_sch, Tube_1-2.kicad_sch, Tube_3-4.kicad_sch, Tube_5-6.kicad_sch]
2025-01-06 added DMC
    [Main.kicad_pcb]
2025-01-15 Added GPS
    [GPS.FCStd, Main.kicad_pcb, Main.kicad_sch, RTC.FCStd, Socket.kicad_pcb, Tube_1-2.kicad_sch, Tube_3-4.kicad_sch, Tube_5-6.kicad_sch]
